noahstout1/external-ventricular-drain-leveler/hardware/system_preview.png

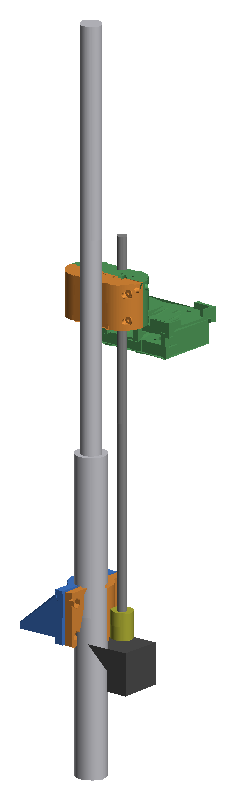
hardware/system_preview.png
