noahstout1/external-ventricular-drain-leveler/hardware/motor_clamp/clamp_pole_29mm_dia_part_A.stl

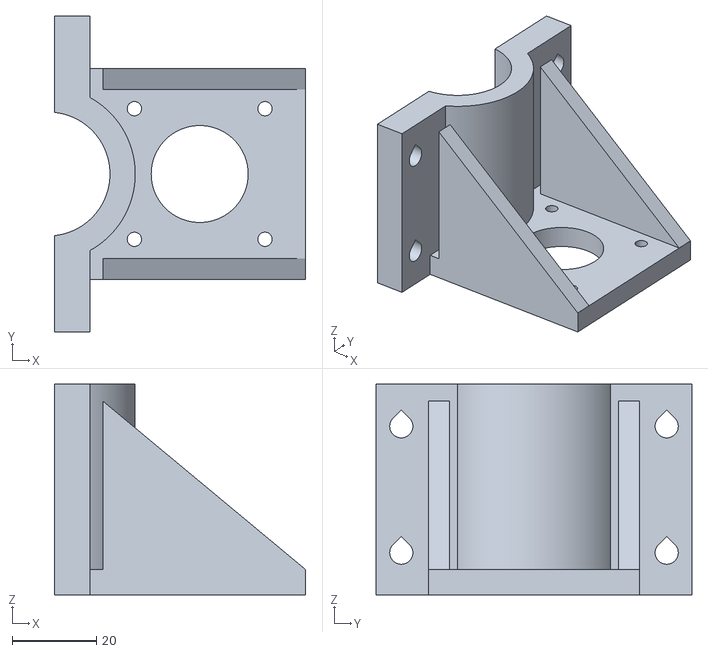
[picture p2: CAD file, 2026-11-12]
hardware/motor_clamp/clamp_pole_29mm_dia_part_A.stl
59.7 x 75.0 x 50.0
