noahstout1/external-ventricular-drain-leveler/Clamp_B_with_MotorDriver_Tray.step

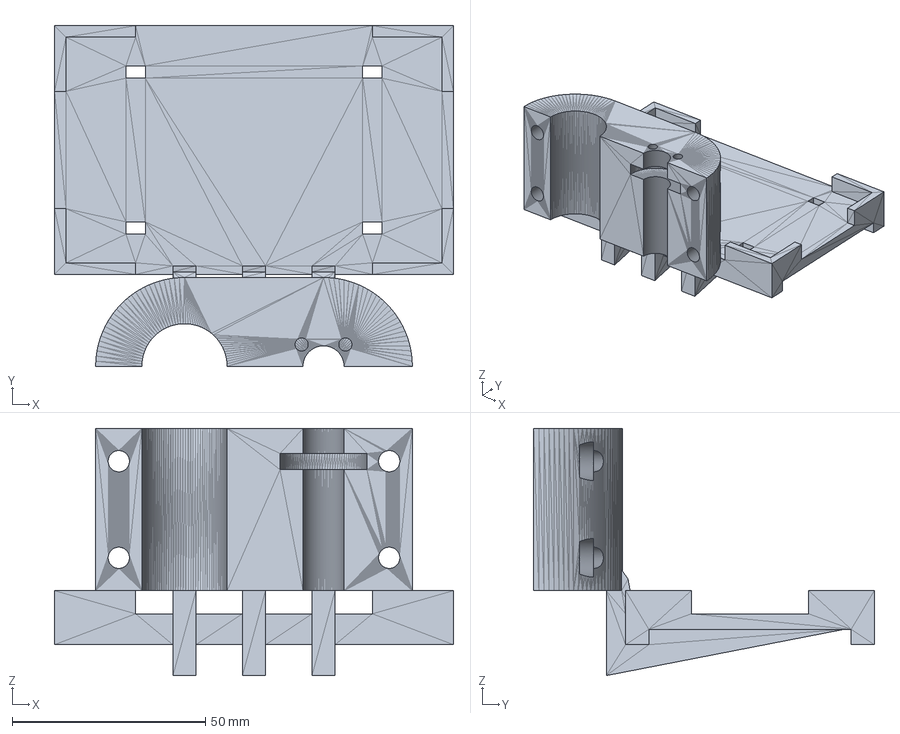
[picture p3: CAD file, 2026-11-12]
Clamp_B_with_MotorDriver_Tray.step
103.3 x 88.2 x 64.0 mm
