noahstout1/external-ventricular-drain-leveler/hardware/motor_clamp/clamp_pole_29mm_dia_part_B.stl

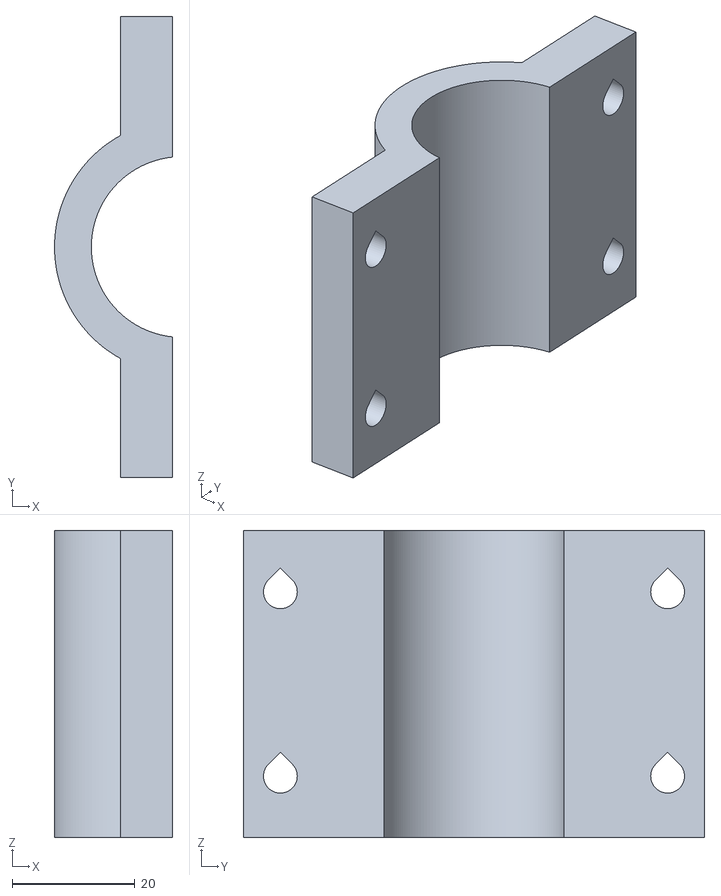
[picture p4: CAD file, 2026-11-12]
hardware/motor_clamp/clamp_pole_29mm_dia_part_B.stl
19.2 x 75.0 x 50.0
