noahstout1/external-ventricular-drain-leveler/Clamp_A_ElectroCookie_6Hole_ScrewMount.step

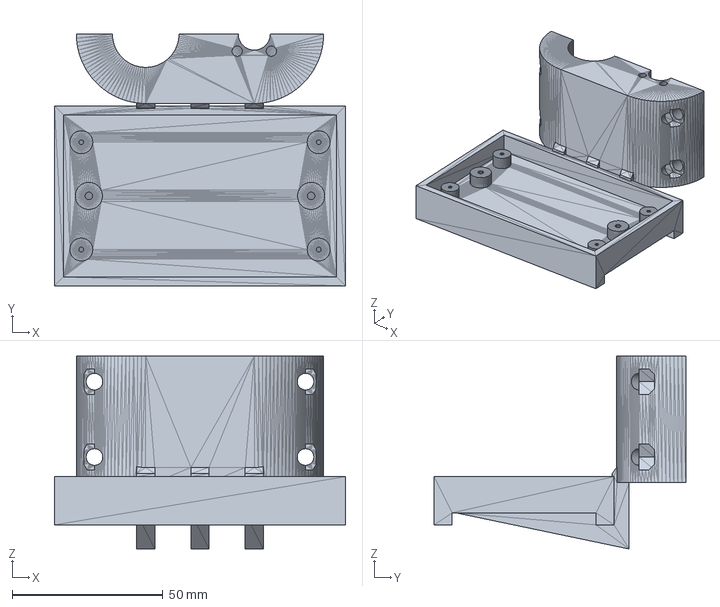
[picture p5: CAD file, 2026-11-12]
Clamp_A_ElectroCookie_6Hole_ScrewMount.step
96.5 x 83.5 x 64.0 mm
