noahstout1/external-ventricular-drain-leveler/hardware/nut_clamp/Nut_Clamp_A_Threaded.stl

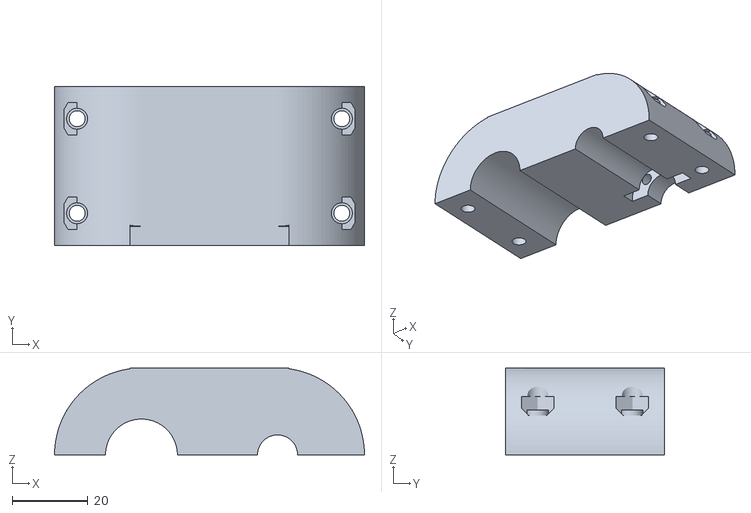
[picture p6: CAD file, 2026-11-12]
hardware/nut_clamp/Nut_Clamp_A_Threaded.stl
82.0 x 42.0 x 23.0
