noahstout1/external-ventricular-drain-leveler/hardware/nut_clamp/Nut_Clamp_B_DriverTray_BoardUnder.stl

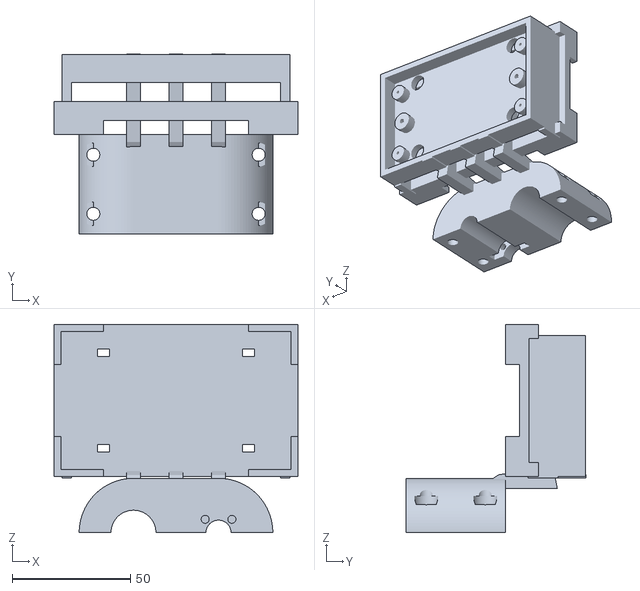
[picture p7: CAD file, 2026-11-12]
hardware/nut_clamp/Nut_Clamp_B_DriverTray_BoardUnder.stl
103.3 x 76.1 x 88.2
