noahstout1/external-ventricular-drain-leveler/(list of files, cad)

Other CAD files:
Clamp_A_ElectroCookie_6Hole_ScrewMount.stl
Clamp_B_with_MotorDriver_Tray.stl
