noahstout1/external-ventricular-drain-leveler/(commit log)

2026-11-03 Split into tragus and pole ESP32 nodes and fix compile/control bugs
    - Move each sketch into its own folder: both .ino files in one folder
    were merged by the Arduino IDE (duplicate setup/loop), so nothing compiled.
    - Tragus node: ESP32 + BMP581 at the tragus, streams raw samples over UDP.
    - Pole node: ESP32 + BMP581 at the EVD zero + TB6600/NEMA 17; computes the
    misalignment and runs the correction loop (replaces sensor/actuator nodes).
    - Reset the averaging window after any move and after tragus link gaps, so
    corrections never act on pre-move or stale data.
    - Auto-detect BMP581 at 0x47/0x46, pace EVD read retries, non-blocking
    serial output, longer WiFi reconnect interval.
    - Protocol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
    [evd_pole_node.ino, evd_protocol.h, evd_tragus_node.ino]
2026-11-03 Fix constant NOISY flag: judge the averaged reading, enable sensor IIR
    - NOISY compared the per-sample spread (~1.2-2 cm for two healthy BMP581s)
    against 1.5 cm, so it fired almost all the time. It now uses the 1-sigma
    uncertainty of the 3 s window average, limit 0.5 cm (= TARGET_CM).
    - Enable the BMP581 on-chip IIR filter (coeff 3) on both nodes, and put the
    chip back into normal mode afterwards (the Bosch setter leaves it in standby).
    - Post-move sample hold raised to 2 s to cover the IIR lag.
    [evd_pole_node.ino, evd_protocol.h, evd_tragus_node.ino]
2026-11-03 Fix stuck auto-correction, noise check, and add auto-tare
    - Confirm step tolerates brief unusable readings (up to 3 s) instead of
    cancelling on a single noisy/late sample; logs why it aborts.
    - NOISY flag and tare noise check now use uncertainty of the window mean
    (sd/sqrt(N), limit 0.5 cm) instead of per-sample spread.
    - Status line shows mean and per-sample uncertainty.
    - Remove per-cycle max travel fault (soft limits still apply).
    - Force a one-time tare 60 s after boot unless already tared manually.
    - Discard wrong-size UDP packets with udp.clear() on both nodes.
    [evd_pole_node.ino, evd_tragus_node.ino]
2026-11-09 Add GPIO4 push button: 1 click = tare, 2 clicks = toggle auto
    - External momentary button on GPIO4 to GND (internal pull-up); the onboard
    BOOT button (GPIO0) uses the same click scheme.
    - Debounced click counting: acts 400 ms after the last release; holds over
    1.5 s and 3+ clicks are ignored.
    - 1 click tares (forced by default, BUTTON_TARE_FORCE); 2 clicks toggle auto.
    - LED confirms: 1 flash tared, 2 auto ON, 3 auto OFF, rapid flicker refused.
    - README: button wiring, pole-node pin map, button actions.
2026-11-09 Wait for stable temps before tare; add cooldown and per-cycle travel cap
    - Tare now waits for T_STABLE instead of forcing: 1 click (or 't') tares
    immediately if stable, otherwise waits and tares itself once stable
    (LED blip each second). Click again while waiting (or 'T') forces it.
    - Power-up tare uses the same wait (forced after 10 min) instead of a
    forced tare at 60 s. No correction cycles start while a tare is waiting.
    - MAX_TEMP_DRIFT_FROM_TARE_C 2.0 -> 0.5 C (~2 cm false error with TCO = 0).
    - 60 s cooldown between correction cycles; turning auto on resets it.
    - Restore a 50 mm per-cycle travel cap (CYCLE_LIMIT fault).
    - README: waiting tare, correction limits, draft shields and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
    [evd_pole_node.ino]
2026-11-09 Simplify Serial Monitor output on both nodes
    - One plain-language status line every 2 s: auto on/off, state, whether the
    EVD is level / HIGH / LOW, pole position, and the single most important
    issue in words (replaces flag lists and hex fault codes).
    - Events are prefixed with "**" (tare, confirm, correct, aligned, faults).
    - Friendlier state names (WATCHING, CONFIRMING, ...); shared evdIssue() and
    evdDescribeError() helpers in evd_protocol.h keep both nodes consistent.
    - Link connect/disconnect announced once on both nodes.
    - Detailed data kept behind 'v' (verbose status), 'p' (details), 'r' (raw).
    - README: how to read the Serial Monitor.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
    [evd_pole_node.ino, evd_protocol.h, evd_tragus_node.ino]
2026-11-09 Add 3D-printable IV pole clamp for the NEMA 17 and TB6600
    - Two-piece split collar (4x M5, nut traps) that grips the IV pole.
    - Part A: NEMA 17 plate (31 mm pattern, 23 mm boss hole) with side ribs;
    lead screw runs parallel to the pole.
    - Part B: sleeve for a 96 x 71 x 37 mm TB6600, opposite the motor, open
    ends for terminals, vent/DIP-switch windows, corner ledges, crush ribs.
    - STLs for 58 mm and 29 mm diameter poles, previews, and the parametric
    generator (make_clamp.py, needs manifold3d).
    [clamp_pole_29mm_dia_part_A.stl, clamp_pole_29mm_dia_part_B.stl, clamp_pole_58mm_dia_part_A.stl, clamp_pole_58mm_dia_part_B.stl]
2026-11-10 Remove TB6600 sleeve from the pole clamp (motor-only again)
    Part B is back to a plain half collar with M5 nut traps. Regenerated STLs
    and previews for both pole sizes; dropped the driver parameters from
    make_clamp.py and the driver steps from the README.
    [clamp_pole_29mm_dia_part_B.stl, clamp_pole_58mm_dia_part_B.stl]
2026-11-10 Fix "evdIssue was not declared": move status-text helpers into the sketches
    The Serial Monitor cleanup put evdIssue()/evdDescribeError() in
    evd_protocol.h, so a sketch folder holding the new .ino next to an older
    copy of the header failed to compile. The plain-language helpers now live
    in each .ino (stateText, issueText, errorText), and evd_protocol.h is back
    to protocol-only, so any protocol-v2 header works.
    [evd_pole_node.ino, evd_protocol.h, evd_tragus_node.ino]
2026-11-10 Raise per-cycle travel cap from 50 mm to 200 mm
2026-11-10 Raise soft travel limits from 150 mm to 200 mm each way
2026-11-10 Invert stepper direction: corrections were driving the pole the wrong way
    Firmware correctly commanded DOWN when the EVD sensor sat above the
    tragus, but the motor moved the pole UP. Set DIR_INVERT so step
    direction matches the physical wiring for all moves.
    [evd_pole_node.ino]
2026-11-12 The stl and step files for the top half of clamp.
    [Clamp_A_ElectroCookie_6Hole_ScrewMount.step, Clamp_A_ElectroCookie_6Hole_ScrewMount.stl, Clamp_B_with_MotorDriver_Tray.step, Clamp_B_with_MotorDriver_Tray.stl]
2026-11-12 Match clamps to the 29/19 mm pole; revise nut clamp; move board holder
    The IV pole is 29 mm where the motor clamp sits and 19 mm where the nut
    clamp sits. Both sections share one axis, so the lead screw is parallel
    only if it is the same distance (36 mm) from the pole axis at both clamps.
    Motor clamp (hardware/motor_clamp):
    - 29 mm bore, lead screw 36 mm out; motor on the outside face of an end
    plate so it clears the collar. Replaces the 58/29/22 mm attempts.
    - Bolts sit outside the plate with a clear head/driver path (heads on A,
    M5 hex nuts in B); 50 mm collar; teardrop holes; 3 mm squeeze gap.
    Nut clamp (hardware/nut_clamp, generated from the team's root STLs by
    modify_nut_clamp.py;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
    [Nut_Clamp_A_Threaded.stl, Nut_Clamp_B_DriverTray_BoardUnder.stl, clamp_pole_29mm_dia_part_A.stl, clamp_pole_29mm_dia_part_B.stl, clamp_pole_58mm_dia_part_A.stl, clamp_pole_58mm_dia_part_B.stl]
2026-11-12 Nut clamp notes: protoboard (not breadboard), M2 corners / M3 middle
    The holder's existing holes already suit the team's screws: 1.6 mm corner
    pilots for M2 and 2.5 mm middle pilots for M3, ~4.5 mm deep, so no
    geometry change. Docs now say protoboard and give screw sizes (M2 x 6,
    M3 x 6 with a 1.6 mm board).
